somedudenamedtony/abyss/hardware/rodi-combined-mount.png

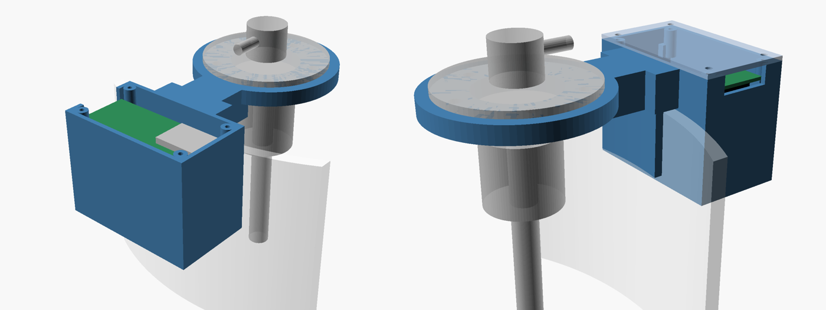
hardware/rodi-combined-mount.png
