somedudenamedtony/abyss/hardware/rodi-rim-mount.png

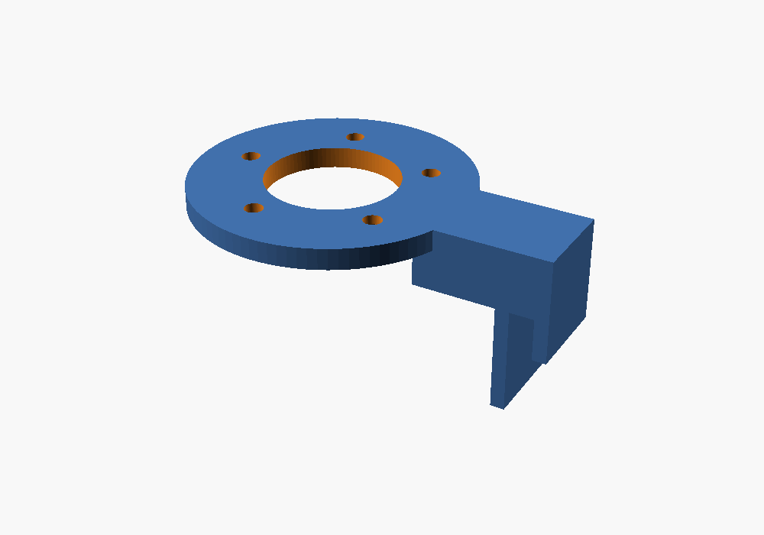
hardware/rodi-rim-mount.png
