somedudenamedtony/abyss/hardware/rodi-combined-mount-lid.stl

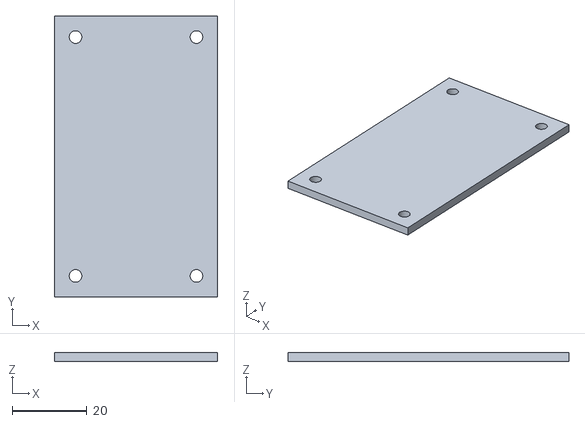
[picture p3: CAD file, 2026-11-10]
hardware/rodi-combined-mount-lid.stl
43.7 x 75.3 x 2.40
