somedudenamedtony/abyss/hardware/rodi-combined-mount-body.stl

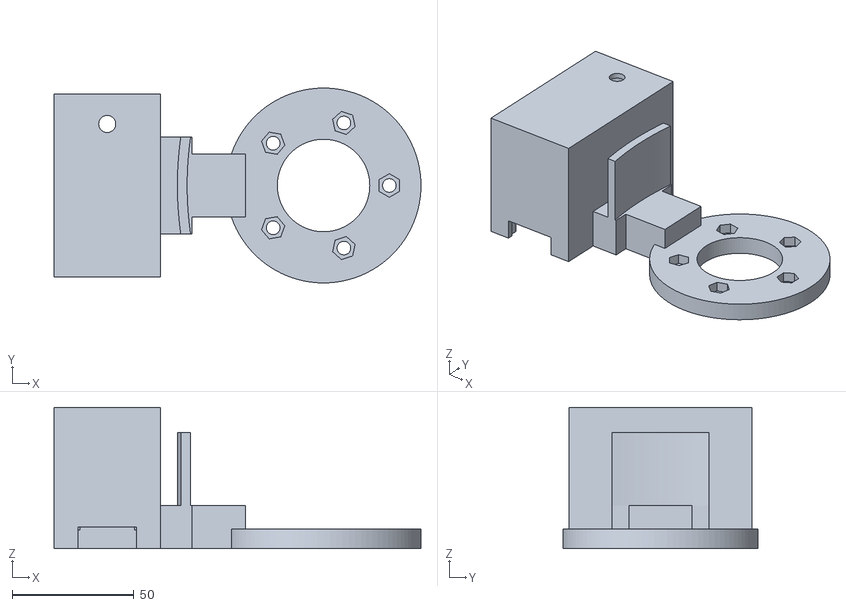
[picture p4: CAD file, 2026-11-10]
hardware/rodi-combined-mount-body.stl
150.7 x 80.0 x 58.0
