somedudenamedtony/abyss/hardware/rodi-rim-mount.stl

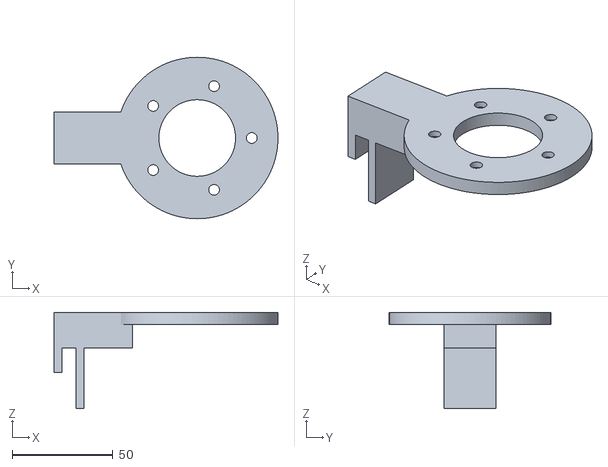
[picture p5: CAD file, 2026-11-08]
hardware/rodi-rim-mount.stl
111.0 x 80.0 x 47.7
