somedudenamedtony/abyss/(commit log)

2026-10-25 Add RODI reservoir level monitor (ESPHome + Home Assistant)
    ESPHome firmware for an ESP32-S3 reading a 0-190 ohm float sender through
    a 220 ohm divider on ADC1, with a standalone web_server, sender fault
    detection, and a lifetime usage counter that ignores refills.
    Home Assistant package with daily/weekly usage, 7-day average, days
    remaining, and low / critical / runaway / sensor-fault alerts.
    Calibration points are placeholders until the sender is installed.
    Claude-Session: https://claude.ai/code/session_01NBCuT52bUL6cAhNTFPeaRF
    [rodi-reservoir.yaml, rodi_reservoir.yaml, rodi_reservoir_card.yaml]
2026-11-07 Add PETG rim mount for the float sender and estimate calibration for 33-241 Ohm
    - hardware/rodi-rim-mount.scad (+ STL, preview): parametric rim hook,
    sender 60mm inside the wall, flange seat raised so the rod tip hangs
    1" off the floor. SAE 5-bolt pattern with captive nuts.
    - hardware/calibration_estimate.py: ohms -> usable gallons from float
    travel and bucket taper.
    - ESPHome: inverted 33-241 Ohm calibration (exact interpolation),
    usable capacity 4.85 gal, fault threshold raised to 350 Ohm.
    Claude-Session: https://claude.ai/code/session_01WL2RN1fANNnGegQXWrXMTf
    [rodi-reservoir.yaml, rodi-rim-mount.scad, rodi-rim-mount.stl]
2026-11-09 Sort calibrate_linear datapoints ascending so ESPHome validates
    Claude-Session: https://claude.ai/code/session_01WL2RMzKXQFA5NkzbDZrLtT
    [rodi-reservoir.yaml]
2026-11-09 Emit and document calibration points in ascending ohm order
    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
2026-11-09 Rescale calibration to the ohms the ESP32 actually reports
    Bench test: float on the bottom stop reads 212.1 Ohm on the device
    (1.620 V) vs 241 Ohm on a meter; the top stop reads ~29 Ohm vs 33.
    Both are ~0.88x, so scale the estimate points by 212.1/241.
    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
    [rodi-reservoir.yaml]
2026-11-09 Add a Reset Water Used button
    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
    [rodi-reservoir.yaml]
2026-11-09 Send reservoir alerts to Fat Amy, add empty alert and tracker card
    Alerts now go to notify.mobile_app_fat_amy. New 'empty' alert fires when the
    float sits on its bottom stop (below 0.35 gal, since the sender can't read
    lower than ~0.30), repeating every 2h. Critical default moves to 0.75 gal so it
    doesn't overlap. The dashboard card adds a gallons gauge, 7-day level history,
    daily usage bars, thresholds and a reset button.
    Claude-Session: https://claude.ai/code/session_01WL2RN1V68o9kiDbyWPtRWn
    [rodi_reservoir.yaml, rodi_reservoir_card.yaml]
2026-11-09 Add combined sender + ESP32-S3 rim mount with M5 flange pattern
    One PETG part replaces the separate rim mount and controller box:
    - Sender flange plate uses the drawing's uneven 5-hole pattern
    (72/68/80/68/72 deg, 54mm circle) with M5 nut traps; the 80 deg cable
    gap faces the wall.
    - Controller box hangs outside the rim with the board lying flat, pins
    down, over a 48mm wiring bay for Dupont jumpers, lever nuts, 220R and
    the 0.1uF cap. Sender cable hole widened to 7mm.
    - Rim hook uses the controller box gap (6.95mm, box back as outer jaw)
    with the inner leg curved to the bucket radius.
    Claude-Session: https://claude.ai/code/se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
    [rodi-combined-mount-body.stl, rodi-combined-mount-lid.stl, rodi-combined-mount.scad, rodi-reservoir.yaml]
2026-11-10 Filter reservoir level spikes with a second median stage
    The 15-sample median let through ~+3% blips lasting several seconds
    (Wi-Fi bursts or float bob), and each one also got counted as usage when
    it dropped back. Add a 5-window (75s) median published once a minute and
    light averaging for the remaining jitter. Works without the 0.1uF cap.
    Claude-Session: https://claude.ai/code/session_01WL2RN3n6PvujKHrtabqbki
    [rodi-reservoir.yaml]
